yusufborham/Balancing-a-ball-on-a-beam/Matlab/Model.png

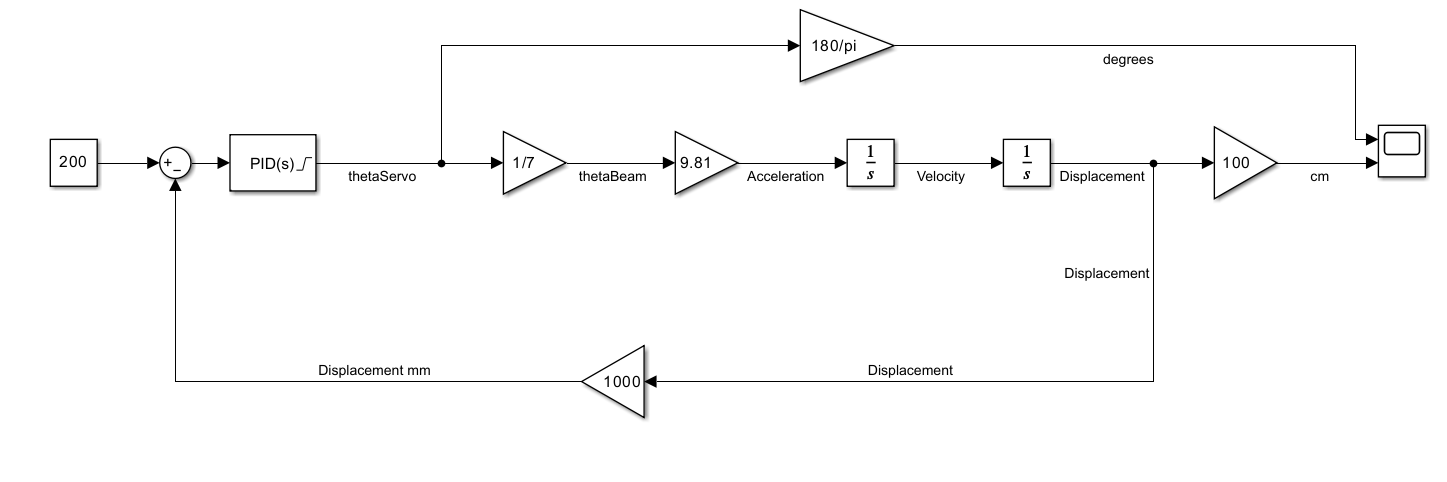
Matlab/Model.png
