yusufborham/Balancing-a-ball-on-a-beam/balance_3D_files/Hinge_1.stl

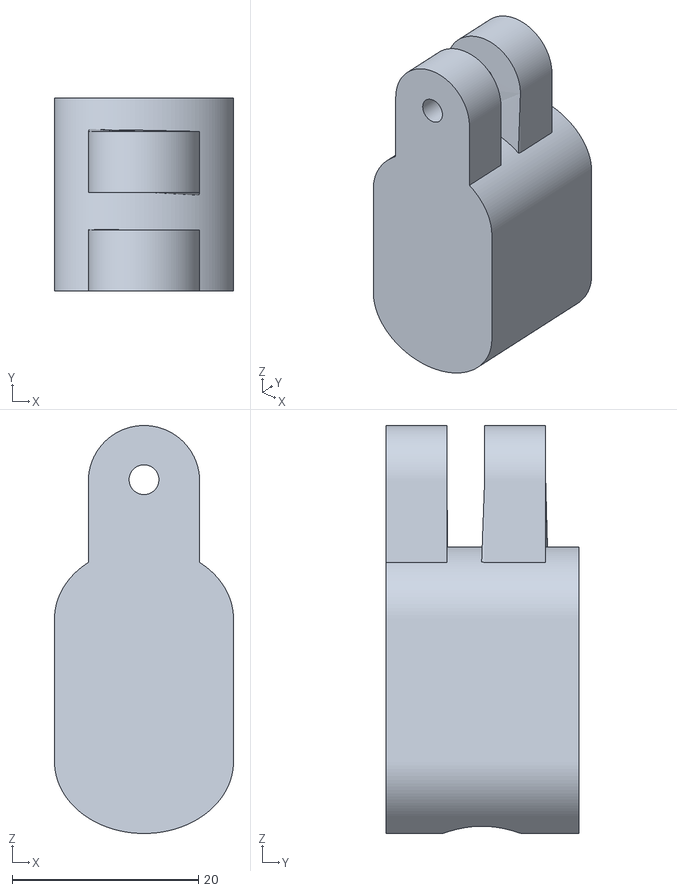
[picture p9: CAD file, 2024-12-24]
balance_3D_files/Hinge_1.stl
19.2 x 20.8 x 43.9
