yusufborham/Balancing-a-ball-on-a-beam/balance_3D_files/Small_hinge_1.stl

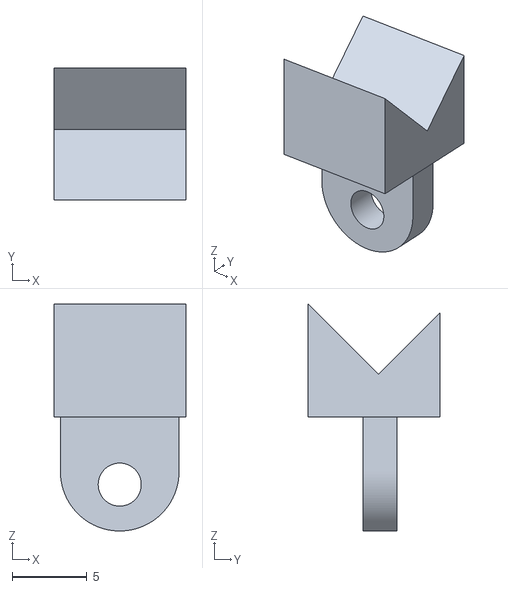
[picture p10: CAD file, 2024-12-24]
balance_3D_files/Small_hinge_1.stl
8.83 x 8.83 x 15.2
