yusufborham/Balancing-a-ball-on-a-beam/balance_3D_files/Disc3.stl

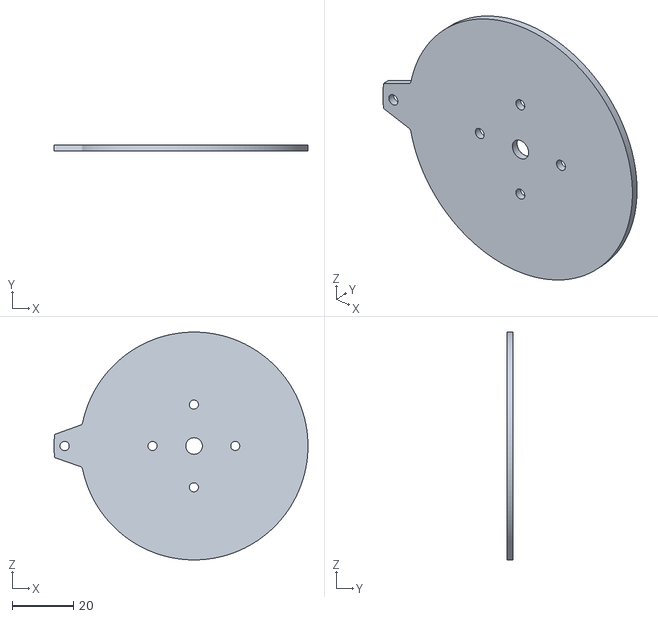
[picture p11: CAD file, 2024-12-24]
balance_3D_files/Disc3.stl
82.9 x 2.00 x 74.4
