yusufborham/Balancing-a-ball-on-a-beam/balance_3D_files/End_stop.stl

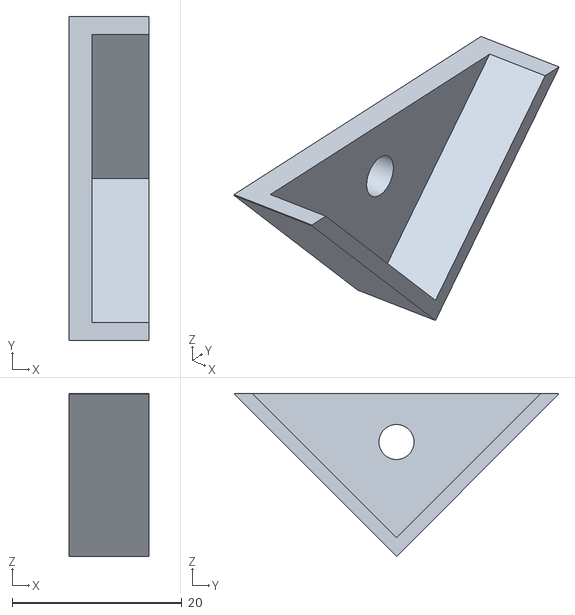
[picture p12: CAD file, 2024-12-24]
balance_3D_files/End_stop.stl
9.42 x 38.2 x 19.2
