yusufborham/Balancing-a-ball-on-a-beam/balance_3D_files/Disc2.stl

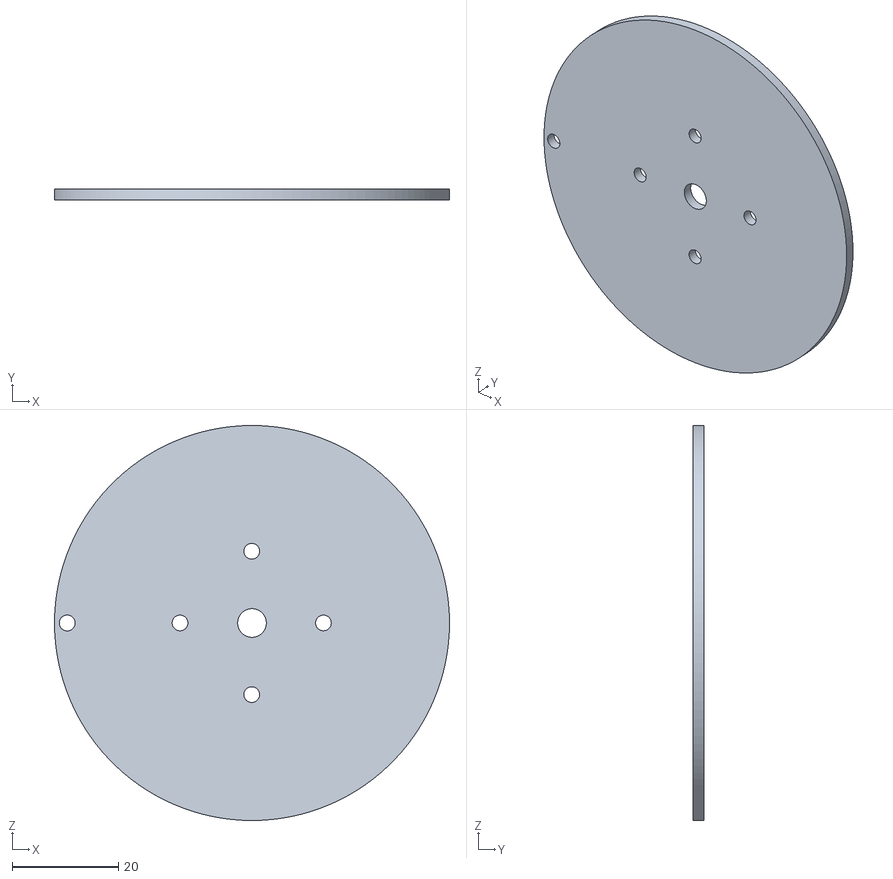
[picture p13: CAD file, 2024-12-24]
balance_3D_files/Disc2.stl
74.4 x 2.00 x 74.4
