yusufborham/Balancing-a-ball-on-a-beam/balance_3D_files/Small_hinge_2.stl

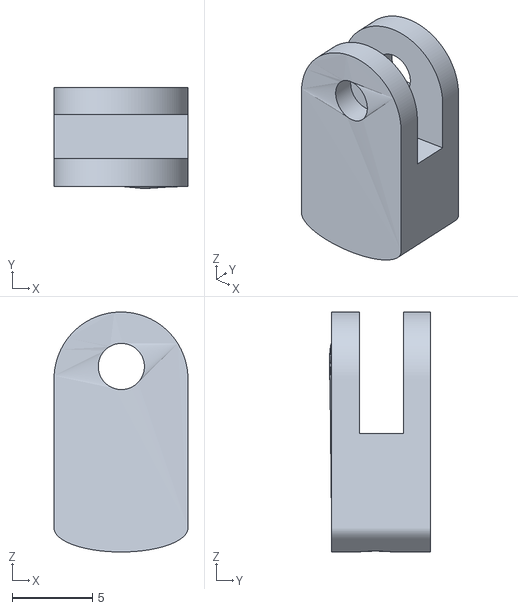
[picture p14: CAD file, 2024-12-24]
balance_3D_files/Small_hinge_2.stl
8.37 x 6.33 x 15.0
