yusufborham/Balancing-a-ball-on-a-beam/balance_3D_files/Hinge_2.stl

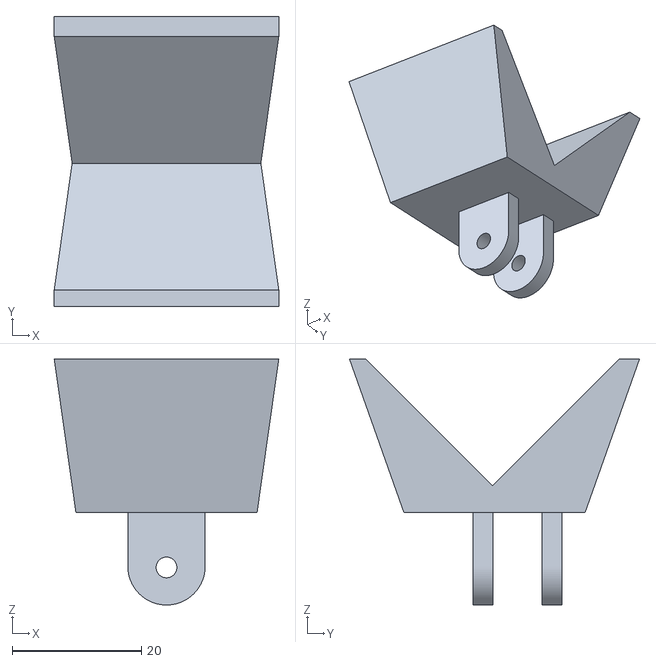
[picture p15: CAD file, 2024-12-24]
balance_3D_files/Hinge_2.stl
34.7 x 44.8 x 38.0
