yusufborham/Balancing-a-ball-on-a-beam/balance_3D_files/Base.stl

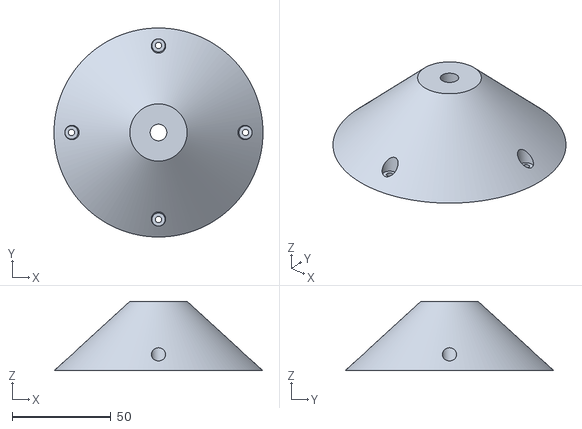
[picture p16: CAD file, 2024-12-24]
balance_3D_files/Base.stl
105.6 x 105.6 x 35.1
