yusufborham/Balancing-a-ball-on-a-beam/balance_3D_files/Disc.stl

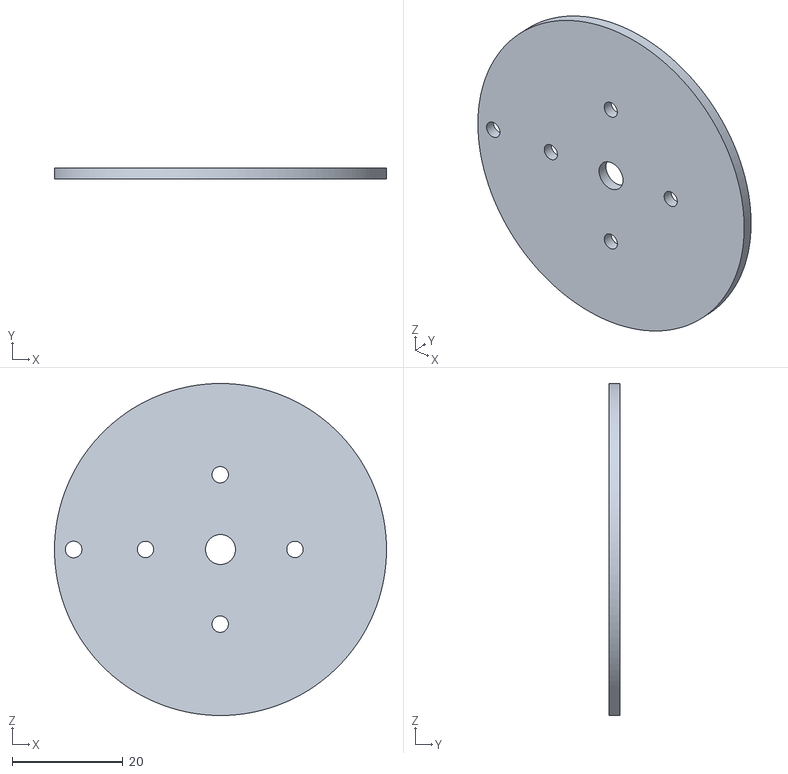
[picture p17: CAD file, 2024-12-24]
balance_3D_files/Disc.stl
60.0 x 2.00 x 60.0
