yusufborham/Balancing-a-ball-on-a-beam/balance_3D_files/Small_hinge_3.stl

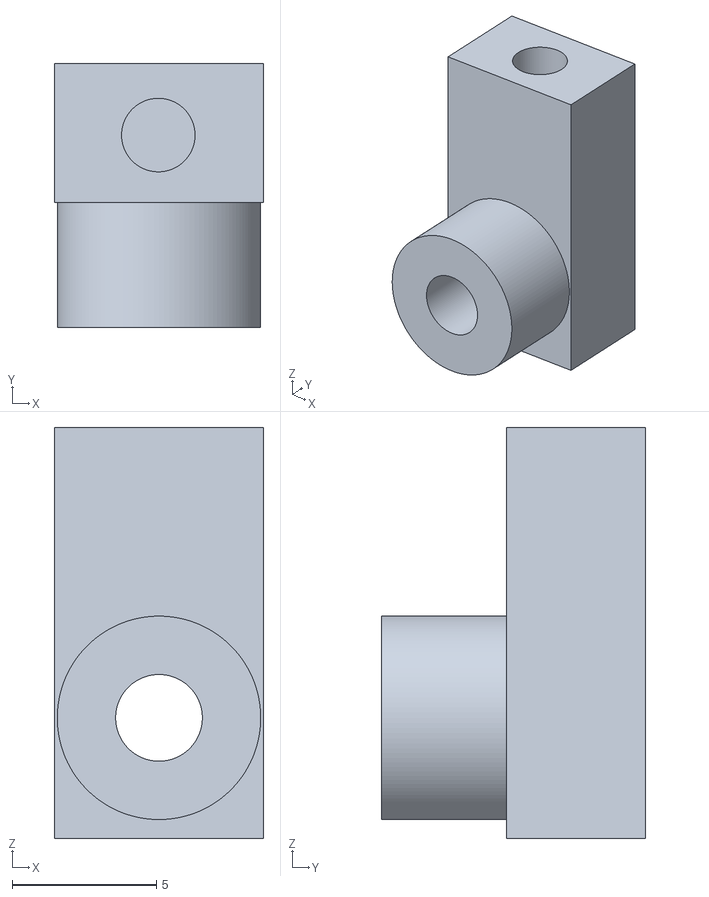
[picture p18: CAD file, 2024-12-24]
balance_3D_files/Small_hinge_3.stl
7.23 x 9.14 x 14.2
