yusufborham/Balancing-a-ball-on-a-beam/balance_3D_files/Servo_support.stl

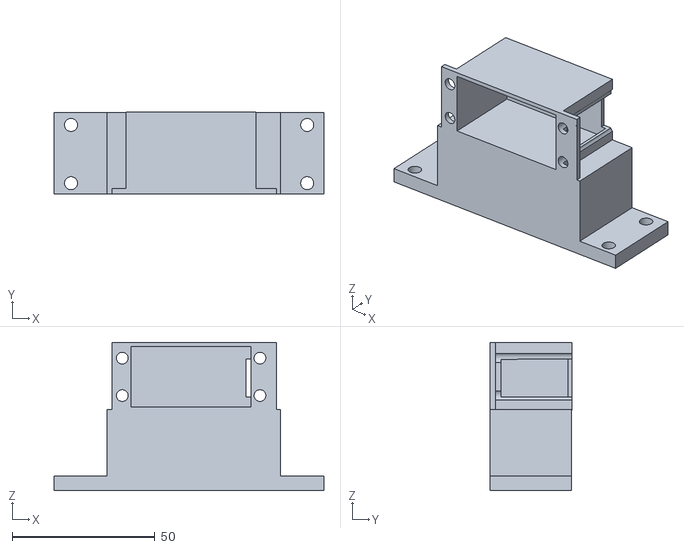
[picture p19: CAD file, 2024-12-24]
balance_3D_files/Servo_support.stl
94.6 x 28.7 x 51.9
