yusufborham/Balancing-a-ball-on-a-beam/balance_3D_files/6. Small_gear (2x).stl

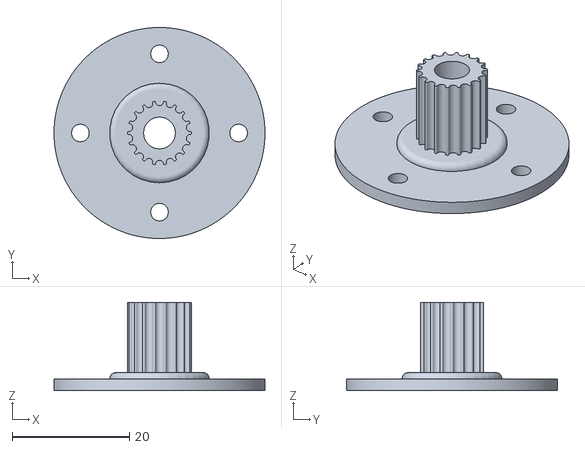
[picture p20: CAD file, 2024-12-24]
balance_3D_files/6. Small_gear (2x).stl
36.0 x 36.0 x 15.1
