yusufborham/Balancing-a-ball-on-a-beam/(list of files, cad)

Other CAD files:
balance_3D_files/Balanza PID pingpong.blend
