yusufborham/Balancing-a-ball-on-a-beam/(commit log)

2024-12-24 added a schematic
2024-12-24 added 3d files
    [6. Small_gear (2x).stl, Balanza PID pingpong.blend, Base.stl, Disc.stl, Disc2.stl, Disc3.stl, End_stop.stl, Hinge_1.stl]
